Jimmyliew/smartfuze-aqua/HARDWARE_ZH.md

# SMARTFUZE AQUA v2.0.1 硬件采购清单与接线指南

适用：**南美白对虾 · 店铺室内循环水（RAS）· 人工配盐低盐度**

接线图：`docs/wiring.svg`（可直接用浏览器打开或打印）

---

## 一、为什么先买这些

在室内循环水系统里，最快让虾死亡的不是 pH，而是：

1. **循环水泵停止**：养殖池缺氧，生物滤器里的硝化细菌开始死亡，1 到 3 天后氨氮和亚硝酸盐暴涨。
2. **气泵停止**：高密度时，溶氧可能在 30 到 60 分钟内降到危险水平。
3. **停电**：上面两件事同时发生，而且监控电脑也一起断电。
4. **集水槽水位异常**：水位太低会让水泵空转烧坏，太高会溢出淹到店铺。

所以采购顺序是：**先保生命，再测水质**。

---

## 二、采购清单（按优先级）

### 第 1 级：放苗前必须到位

| 物品 | 建议规格 | 数量 | 用途 / 注意事项 |
|---|---|---|---|
| UPS 不间断电源 | 600–1000VA，带 USB 或指示灯 | 1 | 接迷你主机、4G 路由器、ESP32 电源。**不要接水泵和气泵**（功率太大会拖垮 UPS）。 |
| 备用电池气泵 | 交直流两用、停电自动启动的增氧泵（水族店常见） | 每个养殖池 1 台 | 停电时自动接管增氧，不依赖任何软件。买回来先拔电测试是否真的自动启动。 |
| 漏电保护器（RCD） | 30mA | 按回路数 | 水 + 电 + 金属探头，必须装。请持证电工安装。 |
| 流量传感器 | 霍尔式脉冲流量计，**口径按水泵出水管选**（例：1/2" 用 YF-S201，1" 用 YF-DN25 等） | 1 | 直接判断循环泵是否在转。装在**机械过滤之后**的干净回水管上，避免被杂物堵住。 |
| 浮球液位开关 | 塑料水平浮球开关（常开/常闭均可，固件可设置） | 2 | 集水槽：一个装在"最低安全水位"，一个装在"溢出前"高度。 |
| 电流互感器（电流钳） | **SCT-013-005**（5A / 1V 输出型） | 1 | 夹在气泵电源线的**一根火线**上，判断气泵是否在转。小功率气泵电流小，不要买 30A 型号（精度不够）。 |
| 电流钳分线器 | AC Line Splitter（插座转接型） | 1 | 不用剪开电源线就能夹单根火线。夹住整条双芯线会读到 0。 |

### 第 2 级：放苗后第一个月内

| 物品 | 建议规格 | 数量 | 用途 / 注意事项 |
|---|---|---|---|
| 溶氧（DO）传感器 | **光学式（荧光法）RS485 Modbus 输出**，带温度补偿 | 1 | 维护最少，最适合长期在线。价格较高。下单前请把型号告诉我，我会在 v2.0.2 写好对应驱动。 |
| RS485 转 TTL 模块 | MAX485 或自动收发型 | 1 | 配合光学溶氧传感器使用。 |
| 测试试剂盒 | 总氨氮、亚硝酸盐、硝酸盐、碱度（KH） | 各 1 套 | 每天测氨氮和亚硝酸盐，直到生物滤器稳定。 |
| 盐度计 | 折射计或电子盐度笔 | 1 | 人工配盐需要每天看，补水后复测。 |
| 校准缓冲液 | pH 4.01 / 6.86 / 9.18 | 各 1 瓶 | pH 探头每 1–2 周校准一次。 |
| pH 探头保存液 | 3M KCl | 1 瓶 | 探头离水时保持湿润，干了就会损坏。 |

### 第 3 级：POC 顺利后，扩展到 1 英亩前

| 物品 | 说明 |
|---|---|
| 工业级在线 pH 电极 | PH-4502C 配的是实验室探头，长期泡水寿命只有几个月。 |
| 隔离型 pH 模块 | 如果水泵一开 pH 读数就跳，就是接地干扰，换隔离模块可解决。 |
| 继电器 + 接触器 | v2.2.0 控制增氧机和水泵用。**增氧机必须接常闭（断电即运转）**。 |
| 户外 Wi-Fi 或 LoRa | 1 英亩场地距离远，ESP32 的 Wi-Fi 可能覆盖不到。 |

### 电子小零件（一次买齐）

- 电阻：4.7kΩ ×2、10kΩ ×5、20kΩ ×3（1/4W 金属膜）
- 10µF 电解电容 ×2
- 3.5mm 母座 ×1（接 SCT-013）
- 防水接线盒 IP65 ×1，防水接头若干
- 2 芯信号线（浮球用）、3 芯线（流量计用）
- 洞洞板或端子板、杜邦线、热缩管
- ESP32 用 5V 2A USB 电源（接在 UPS 上）

---

## 三、ESP32 引脚分配

| 引脚 | 接什么 | 备注 |
|---|---|---|
| GPIO4 | DS18B20 水温（DATA） | 4.7kΩ 上拉到 3V3 |
| GPIO34 | pH 模块 PO（经 20k/10k 分压） | 只能输入的 ADC1 引脚 |
| GPIO27 | 流量计信号（经 10k/20k 分压） | 5V 脉冲降到 3.3V |
| GPIO25 | 低水位浮球 | 另一端接 GND，固件用内部上拉 |
| GPIO26 | 高水位浮球 | 另一端接 GND |
| GPIO35 | SCT-013-005 电流钳 | 需要偏置电路（见下） |
| 3V3 / 5V / GND | 电源 | 所有 GND 必须接在一起 |

### 各传感器接法

**① 水温 DS18B20**：红→3V3，黑→GND，黄→GPIO4，黄与红之间接 4.7kΩ。

**② pH 模块**：V+→5V，G→GND，PO→20kΩ→GPIO34，GPIO34→10kΩ→GND。

**③ 流量计**：红→5V，黑→GND，黄→10kΩ→GPIO27，GPIO27→20kΩ→GND。

**④⑤ 浮球**：每个浮球两根线，一根→GPIO25（或 26），另一根→GND。浮球只走 3.3V 信号，**绝对不能接到任何 230V 线路上**。线长超过 3 米时，可在 GPIO 和 GND 之间加一个 100nF 电容防干扰。

**⑥ 电流钳 SCT-013-005**：
- 偏置电路：3V3→10kΩ→中点，中点→10kΩ→GND，中点→10µF→GND（电容负极接 GND）
- 3.5mm 插头：尖端→GPIO35，套管→中点
- 钳子只夹**一根火线**（用分线器最方便）

---

## 四、固件设置

打开 `firmware/SMARTFUZE_AQUA_ESP32/SMARTFUZE_AQUA_ESP32.ino`：

```cpp
#define ENABLE_FLOW_SENSOR    1   // 装了流量计才改 1
#define ENABLE_LEVEL_SWITCHES 1   // 装了浮球才改 1
#define ENABLE_AIRPUMP_CT     1   // 装了电流钳才改 1
const float FLOW_PULSES_PER_LITRE = 450.0;  // 按你流量计的说明书填写
const float FLOW_MIN_LPM          = 2.0;    // 低于这个流量视为水泵停止
const float AIRPUMP_ON_AMPS       = 0.15;   // 气泵运转判断值，见下方校准
```

没装的传感器保持 0，仪表盘会显示"Not installed"，**绝不会显示假数据**。

### 装好后逐项测试（打开串口监视器，115200）

1. **流量计**：水泵运转时应显示 `flow=xx L/min (pump RUNNING)`。关掉水泵，几秒内变成 `STOPPED`。
   - 读数与实际差太多，就调整 `FLOW_PULSES_PER_LITRE`（用水桶加秒表测一次实际流量）。
2. **浮球**：用手把浮球抬起或放下，观察 `lowSw` / `highSw` 是否变化，`level` 是否显示 low / high / ok。
   - 如果方向相反，把 `LEVEL_LOW_TRIGGERED_WHEN_CLOSED`（或 HIGH）改成 `false`。
3. **电流钳**：分别记下气泵开、关时的 `air=x.xxx A`。把 `AIRPUMP_ON_AMPS` 设为两者中间值。
   - 例：关 0.02A，开 0.40A → 设为 0.15 到 0.2。

---

## 五、放苗前必做：停电和故障演练

**每一项都要实际做一次，确认手机真的会响。**

| 演练 | 操作 | 预期结果 |
|---|---|---|
| 推送测试 | 设置页按"Test emergency" | 所有人手机在静音模式下也响，按"确认"后停止 |
| 水泵停止 | 拔掉循环泵电源 | 约 1 分钟后，手机收到"循环水泵停止"严重报警 |
| 气泵停止 | 拔掉气泵电源 | 备用电池气泵自动启动；约 1 分钟后手机收到报警 |
| 低水位 | 把低水位浮球放下 | 约 30 秒后收到报警 |
| 全店停电 | 关总闸 | UPS 维持电脑和路由器运行；如果 UPS 也耗尽，healthchecks.io 在 5 分钟后通过 Pushover 叫醒你 |
| 断网 | 拔掉 4G 路由器 | healthchecks.io 在约 5 分钟后报警 |

---

## 六、日常维护

| 频率 | 工作 |
|---|---|
| 每天 | 看仪表盘；测氨氮、亚硝酸盐（生物滤器稳定前）；看盐度，补淡水 |
| 每周 | 测碱度并按系统提示补小苏打；抽样称重 30 尾以上，录入养殖周期 |
| 每 1–2 周 | pH 三点校准（记录缓冲液温度）；清洗流量计前的过滤网 |
| 每月 | 按 UPS 自检；演练一次停电；备份 data 文件夹 |

---

## 七、还需要你决定的事

1. **溶氧传感器选哪款**：选好型号后告诉我，我写对应驱动（v2.0.2）。
2. **池子数量和水量**：在设置页填写，用于密度计算和补碱剂量。
3. **夜间谁负责**：每个负责人的手机都要装 Pushover 并加入同一个 Delivery Group。
